wagiminator/ATtiny84-TinyICOC/hardware/TinyICOC_BOM.tsv

ID | Name | Designator | Footprint | Quantity | Manufacturer Part | Manufacturer | Supplier | Supplier Part | Price | LCSC Assembly
1 | 100n | C1 | 0603 | 1 | CC0603KRX7R9BB104 | YAGEO | LCSC | C14663 | 0.0034
2 | 10u | C2 | 0603 | 1 | CL10A106MA8NRNC | SAMSUNG | LCSC | C96446 | 0.0359
3 | 22p | C3,C4 | 0603 | 2 | CL10C220JB8NNNC | SAMSUNG | LCSC | C1653 | 0.0055
4 | ICSP | H1 | ICSP-6-SIDE | 1 | 2X3 2.54mm IDC Box | BOOMELE | LCSC | C11214 | 0.0695
5 | SELFPRG | JP1 | HEADER_2X1 | 1
6 | OLED 0.91 | OLED | I2C OLED 0.91 | 1 | SSD1306 I2C OLED
7 | 10k | R1 | 0603 | 1 | 0603WAF1002T5E | UniOhm | LCSC | C25804 | 0.001
8 | TS24CA | SW1 | SW-SMD_TS24CA | 1 | TS24CA | SHOU HAN | LCSC | C393942 | 0.0235
9 | ATTINY84A-SSU | U1 | SOIC-14_150MIL | 1 | ATTINY84A-SSU | MICROCHIP | LCSC | C144333 | 1.6489
10 | 12MHz | X1 | OSC-SMD_3225 | 1 | X322512MSB4SI | YXC | LCSC | C9002 | 0.0748 | Yes
