wagiminator/ATtiny84-TinyICOC/hardware/TinyICOC_schematic.pdf

## ATtiny84 Microcontroller

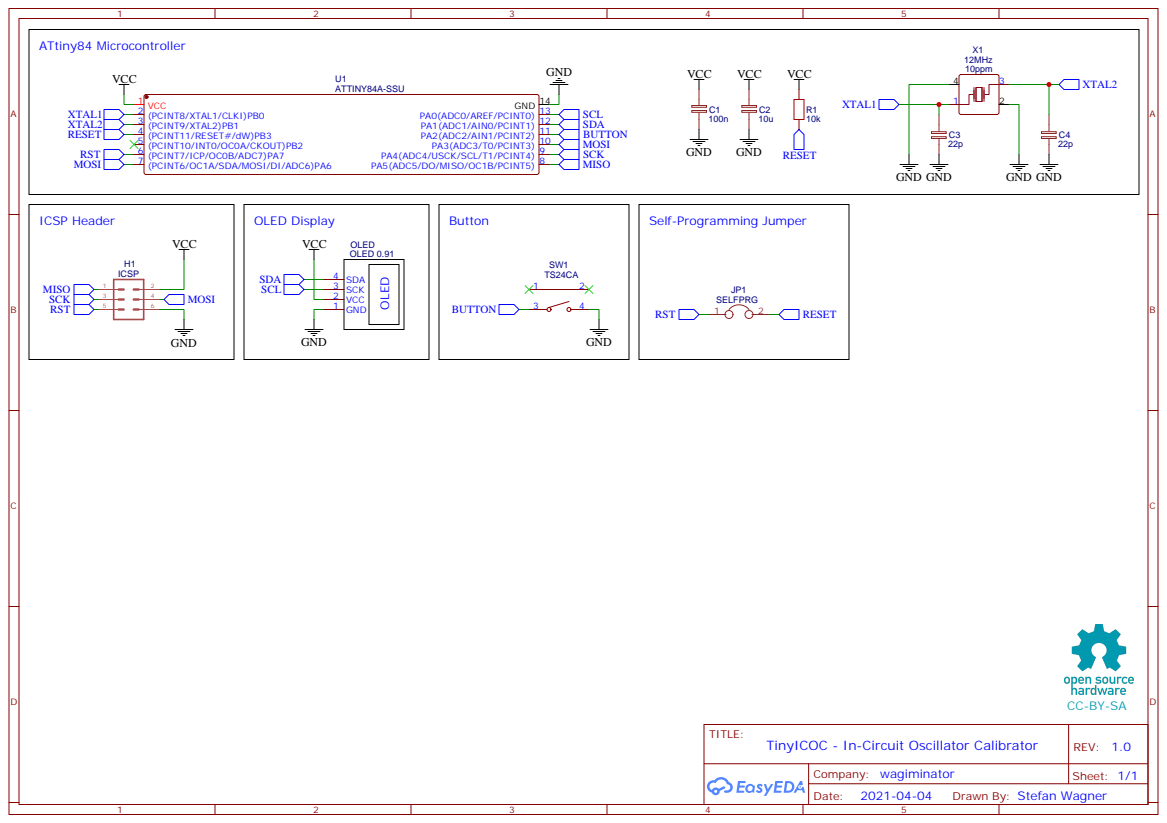
[picture p4: page 1]

Drawn By: Stefan Wagner
